mcastorina/shelf-light/kicad/shelf-light.kicad_pcb

## KiCad design kicad/shelf-light.kicad_pcb (2023-04-06)

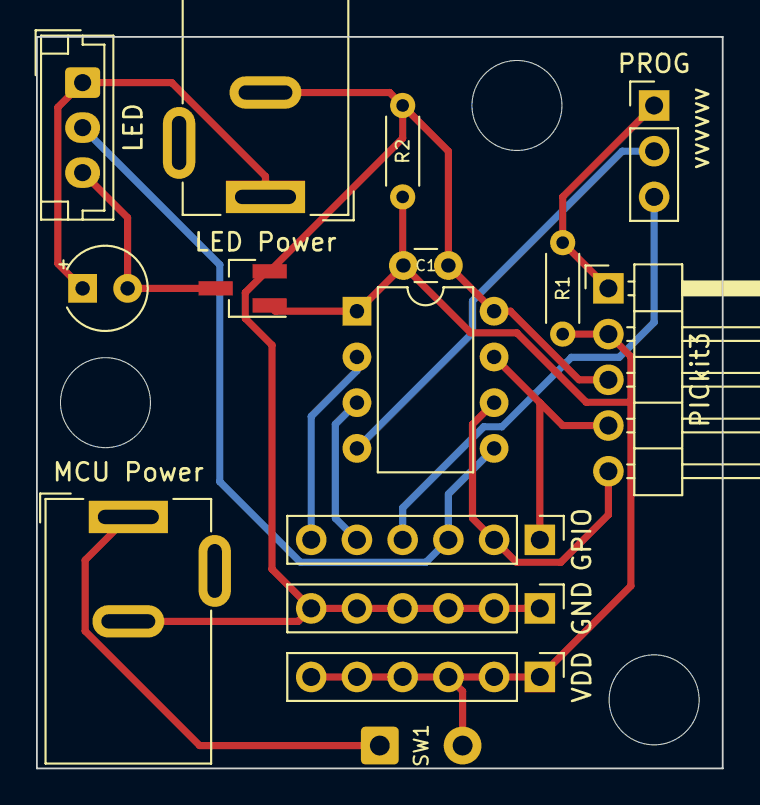
[picture p1: board shelf-light.kicad_pcb from above]

Board: 2 copper layers, 38.1 x 40.6 mm, 18 parts (0 on the bottom side), 13 nets.

Parts:
C1: 100nF; C_Disc_D3.0mm_W1.6mm_P2.50mm
C2: 100mF; CP_Radial_Tantal_D4.5mm_P2.50mm
GND: GND; PinHeader_1x06_P2.54mm_Vertical
GPIO: GPIO; PinHeader_1x06_P2.54mm_Vertical
H1, H2, H3: MountingHole; MountingHole_5mm
LED: LED; JST_EH_B3B-EH-A_1x03_P2.50mm_Vertical
LED Power: LED Power; BarrelJack_Wuerth_6941xx301002
MCU Power: MCU Power; BarrelJack_Wuerth_6941xx301002
PICkit3: PICkit3; PinHeader_1x05_P2.54mm_Horizontal
PROG: vvvvvv; PinHeader_1x03_P2.54mm_Vertical
Q1: NDS355AN; SOT-23_Handsoldering
R1, R2: 10k; R_Axial_DIN0204_L3.6mm_D1.6mm_P5.08mm_Horizontal
SW1: Switch; SolderWire-0.5sqmm_1x02_P4.6mm_D0.9mm_OD2.1mm
U1: PIC16F15313; DIP-8_W7.62mm
VDD: VDD; PinHeader_1x06_P2.54mm_Vertical

Connections:
GND: C1.1, GND.1, GND.2, GND.3, GND.4, GND.5, GND.6, LED Power.2, MCU Power.2, PICkit3.3, Q1.2, R2.2, U1.8
unnamed: C2.1, LED.1, LED Power.1
unnamed: C2.2, LED.3, Q1.3
unnamed: PICkit3.1, PROG.1, R1.2
unnamed: GPIO.1, PICkit3.4, U1.7
unnamed: GPIO.2, PICkit3.5, U1.6
unnamed: MCU Power.1, SW1.1
unnamed: GPIO.3, LED.2, U1.5
unnamed: GPIO.4, PROG.3
unnamed: GPIO.5, U1.3
unnamed: GPIO.6, U1.2
unnamed: PROG.2, U1.4
VDD: C1.2, PICkit3.2, Q1.1, R1.1, R2.1, SW1.2, U1.1, VDD.1, VDD.2, VDD.3, VDD.4, VDD.5, VDD.6
