mcastorina/shelf-light/(commit log)

2020-09-07 Arduino POC
    This sketch uses a potentiometer to calculate the warmth value as a
    function of hue. Hue is then converted to RGB, and a library writes the
    data to the LED strip.
2020-09-09 Update the LED strip only if the color has changed
2020-09-09 Use low power sleep instead of delay
2020-09-10 Add current measurements
2020-10-10 Add MPLabX project for programming the PIC
    The main.c file successfully writes to the LED strip, but needs to be
    expanded to include reading the potentiometer and dynamically updating
    the color.
2020-10-10 Add gitignore for arduino-uno
2020-10-12 Implement analog read and color changing logic
    The ADC is configured to read an analog value from RA4 using Vdd as a
    voltage reference. That value is then converted to a number between 120
    and 360 to be used as the hue value in HSV to RGB conversion.
    Converting from HSV normally uses floating points, but to save
    programming memory it is implemented as fixed point with two decimal
    places.
    [main.c]
2023-04-06 Add kicad files
    [test.kicad_pcb, test.sch]
2023-04-06 Rename kicad project
    If the project fails to load because of the rename, the previous commit
    should work (with the project name of test).
    [shelf-light.kicad_pcb, shelf-light.sch]
